f4ise/RP-LoRa-Mini/Hardware/3D_PCB_BOTTOM.png

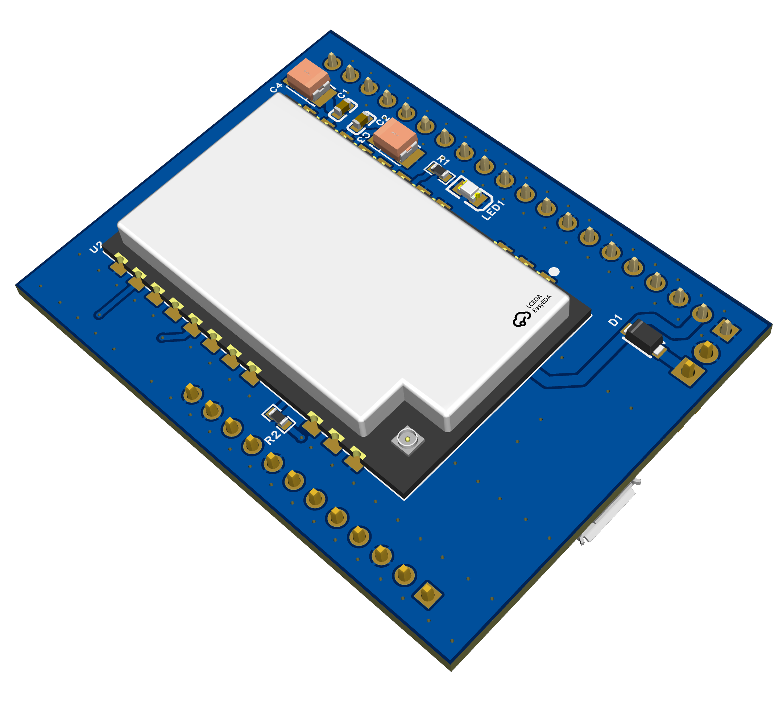
Hardware/3D_PCB_BOTTOM.png
