f4ise/RP-LoRa-Mini/Hardware/3D_PCB_TOP.png

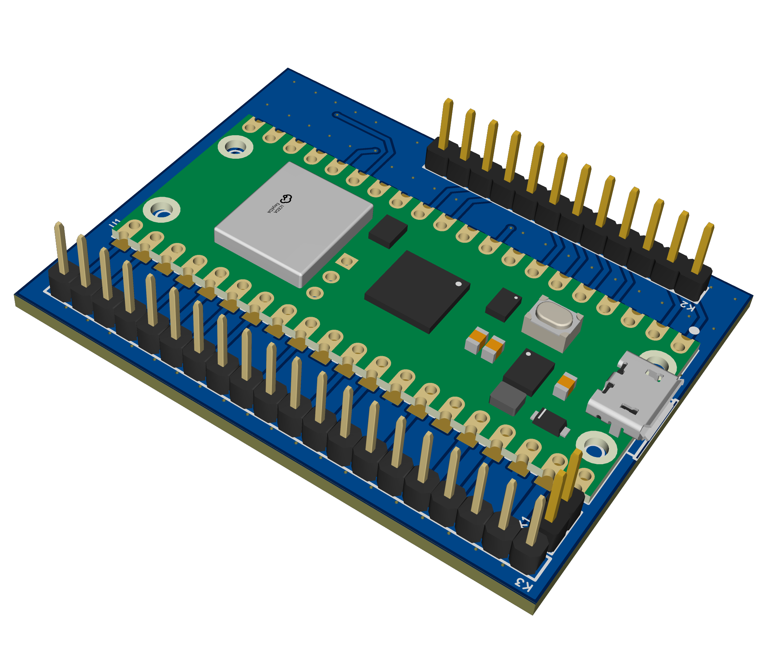
Hardware/3D_PCB_TOP.png
