f4ise/RP-LoRa-Mini/Hardware/BOM_LoRa_Mini_v2.1_PCB_2025-09-03.csv

No. | Quantity | Comment | Designator | Footprint | Value | Manufacturer Part | Manufacturer | Supplier Part | Supplier
1 | 2 | 100nF | C1,C2 | C0603 | 100nF | CC0603KRX7R9BB104 | YAGEO(国巨) | C14663 | LCSC
2 | 2 | 47uF | C3,C4 | CASE-B_3528 | 47uF | CA45-B-10V-47uF-K | CEC(振华新云) | C136658 | LCSC
3 | 1 | MBR120VLSFT1G | D1 | SOD-123F_L2.8-W1.8-LS3.7-RD |  | MBR120VLSFT1G | onsemi(安森美) | C223608 | LCSC
4 | 1 | PZ254V-11-02P | K1 | HDR-TH_2P-P2.54-V-M |  | PZ254V-11-02P | XFCN(兴飞) | C492401 | LCSC
5 | 1 | PZ254V-11-12P | K2 | HDR-TH_12P-P2.54-V-M |  | PZ254V-11-12P | XFCN(兴飞) | C2840012 | LCSC
6 | 1 | PZ254V-11-20P | K3 | HDR-TH_20P-P2.54-V-M-4 |  | PZ254V-11-20P | XFCN(兴飞) | C22465880 | LCSC
7 | 1 | KT-0805R | LED1 | LED0805-R-RD |  | KT-0805R | KENTO | C2295 | LCSC
8 | 1 | 1kΩ | R1 | R0603 | 1kΩ | RC0603FR-071KL | YAGEO(国巨) | C22548 | LCSC
9 | 1 | 200Ω | R2 | R0603 | 200Ω | 0603WAF2000T5E | UNI-ROYAL(厚声) | C8218 | LCSC
10 | 1 | PICO W | U1 | COMM-SMD_L51.0-W21.0-P2.54_PICOW |  | PICO W | Raspberry Pi(树莓派) | C7203003 | LCSC
11 | 1 | E22-900M33S | U2 | COMM-SMD_22P-P2.54-L38.5-W24.0_E22-400M33S |  | E22-900M33S | EBYTE(亿佰特) | C22399506 | LCSC
