f4ise/RP-LoRa-Mini/Hardware/SCH_Schematic_2025-09-03.pdf

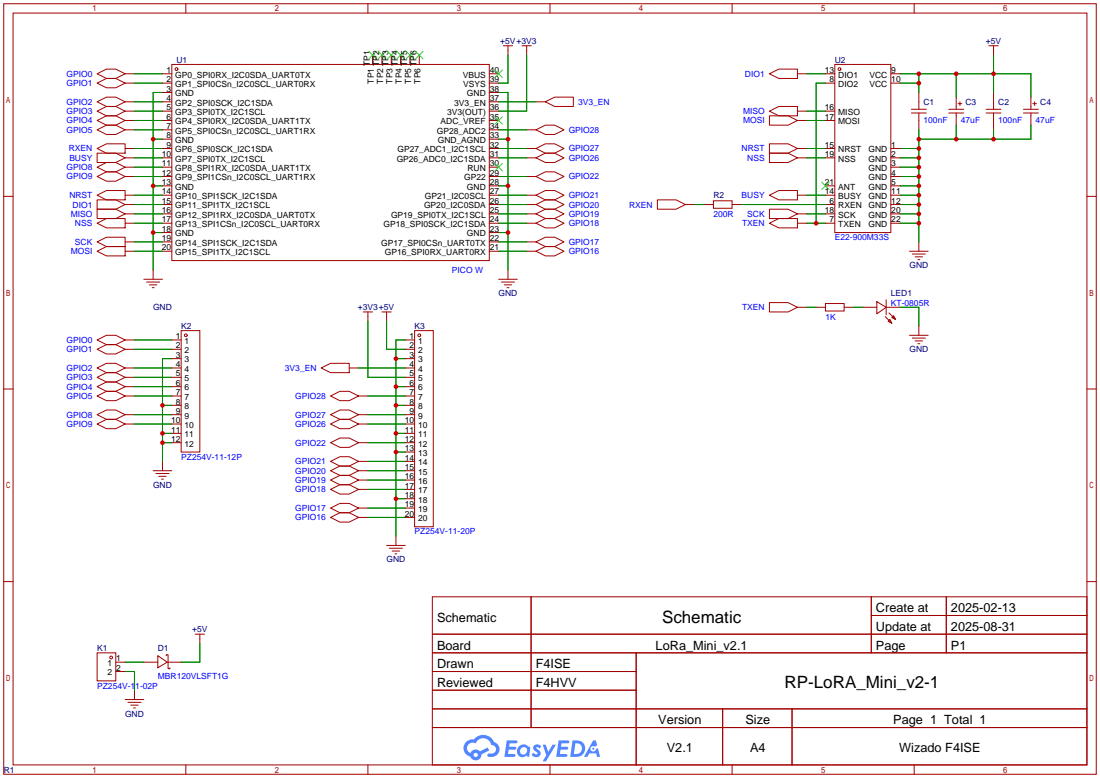
[picture p3: page 1]

Schematic | Schematic | Create at | 2025-02-13

Update at | 2025-08-31

Board | LoRa_Mini_v2.1 | Page | P1
Drawn | F4ISE | RP-LoRA_Mini_v2-1
Reviewed | F4HVV

Version | Size | Page 1 Total 1
V2.1 | A4 | Wizado F4ISE
