f4ise/RP-LoRa-Mini/(list of files, drawings)

Other design files:
Hardware/RP-LoRA_Mini_v2-1.eprj
